speedbird620/footwarm/2022-01-29 15.06.56.jpg

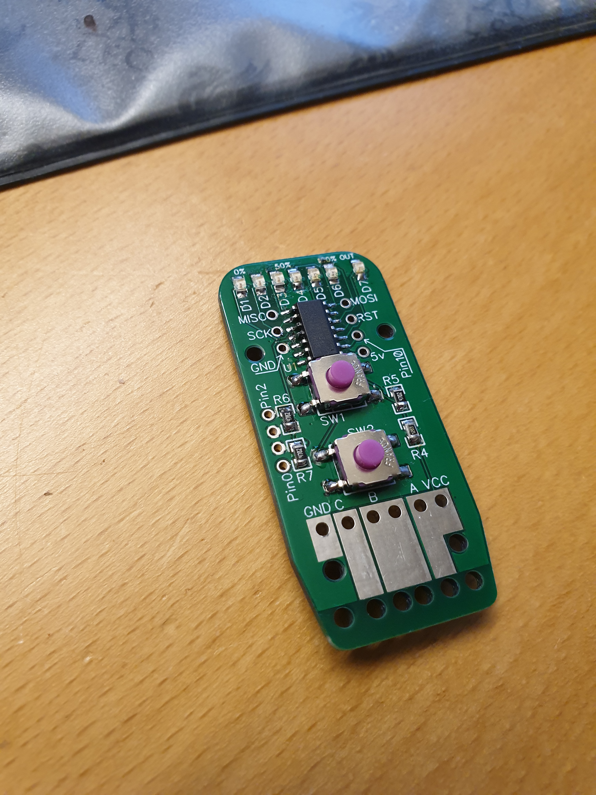
2022-01-29 15.06.56.jpg
