speedbird620/footwarm/2022-01-29 15.07.03.jpg

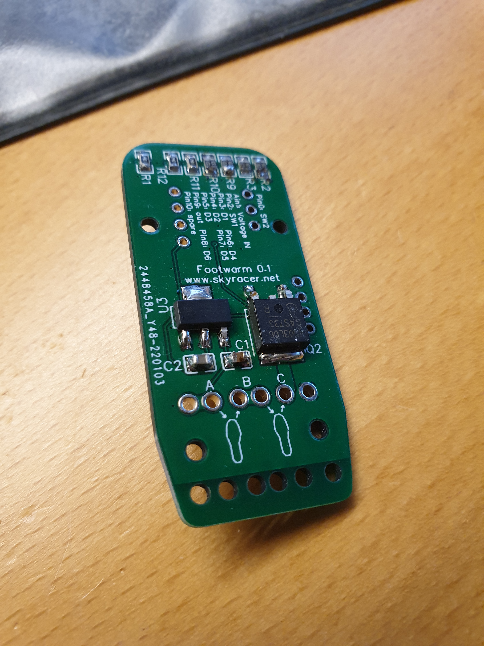
2022-01-29 15.07.03.jpg
