speedbird620/footwarm/Schematic_Footwarm XL_2022-01-15.pdf

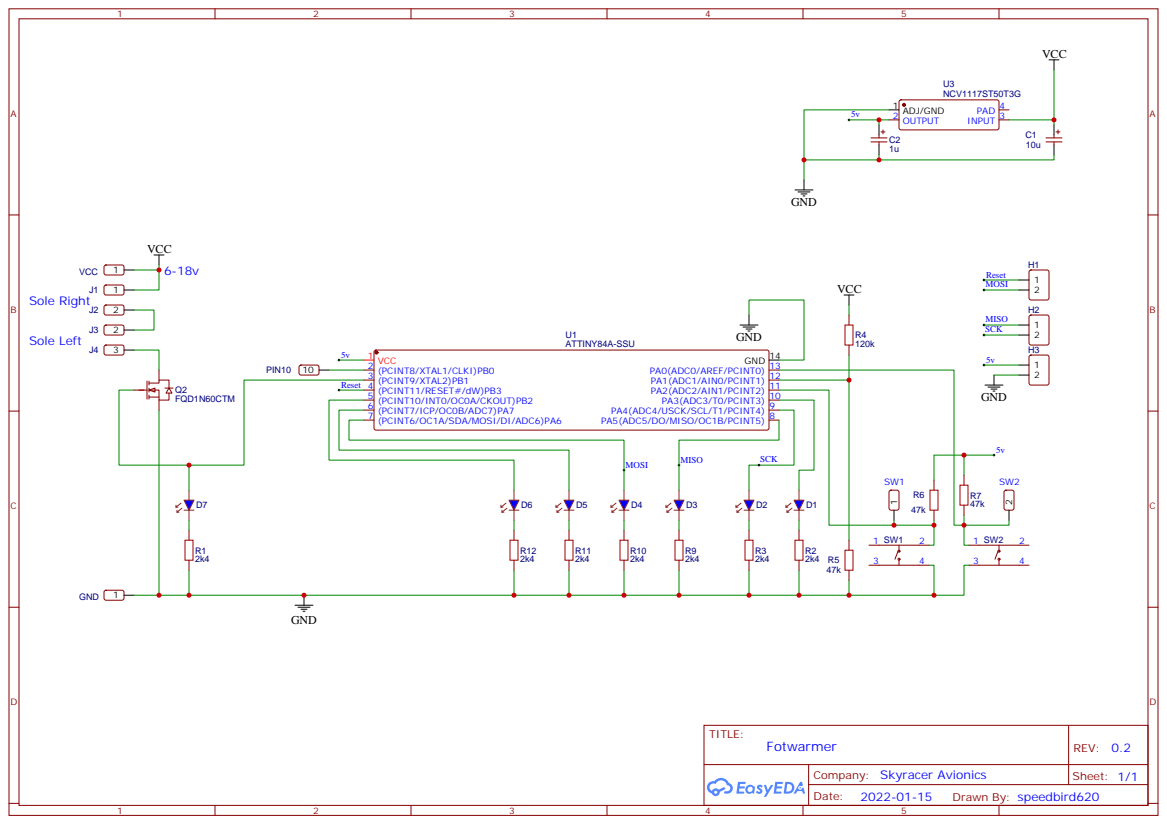
[picture p16: page 1]
